solderparty/rp2040_stamp_carrier_hw/schematics.pdf

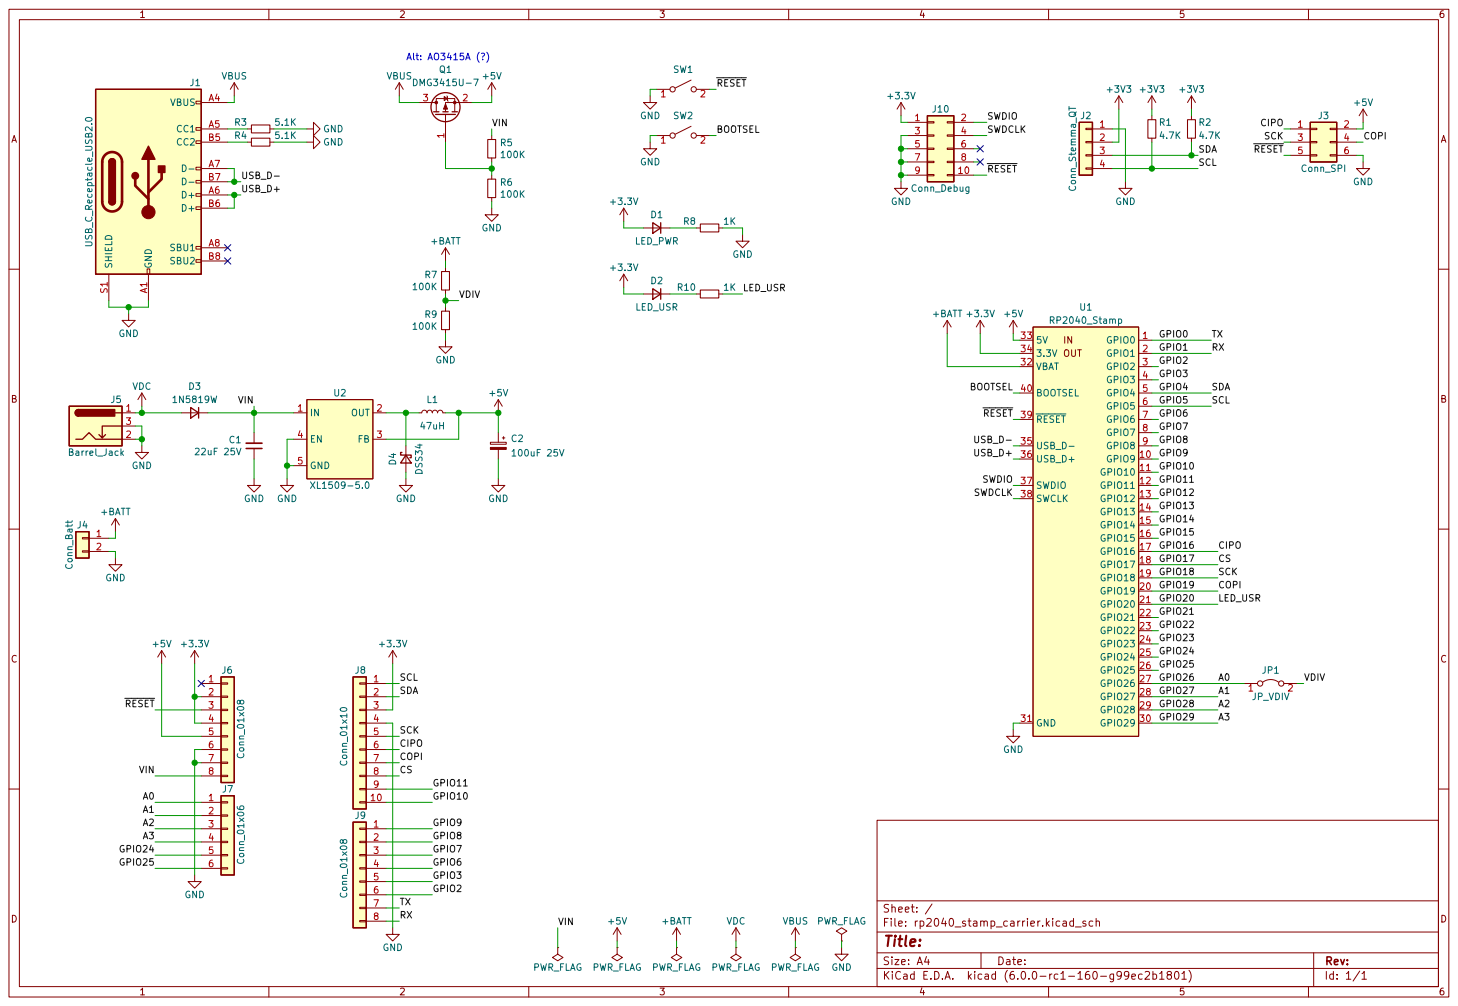
[picture p2: page 1]
