solderparty/rp2040_stamp_carrier_hw/rp2040_stamp_carrier.kicad_sch

## KiCad design rp2040_stamp_carrier.kicad_sch (2021-10-28)

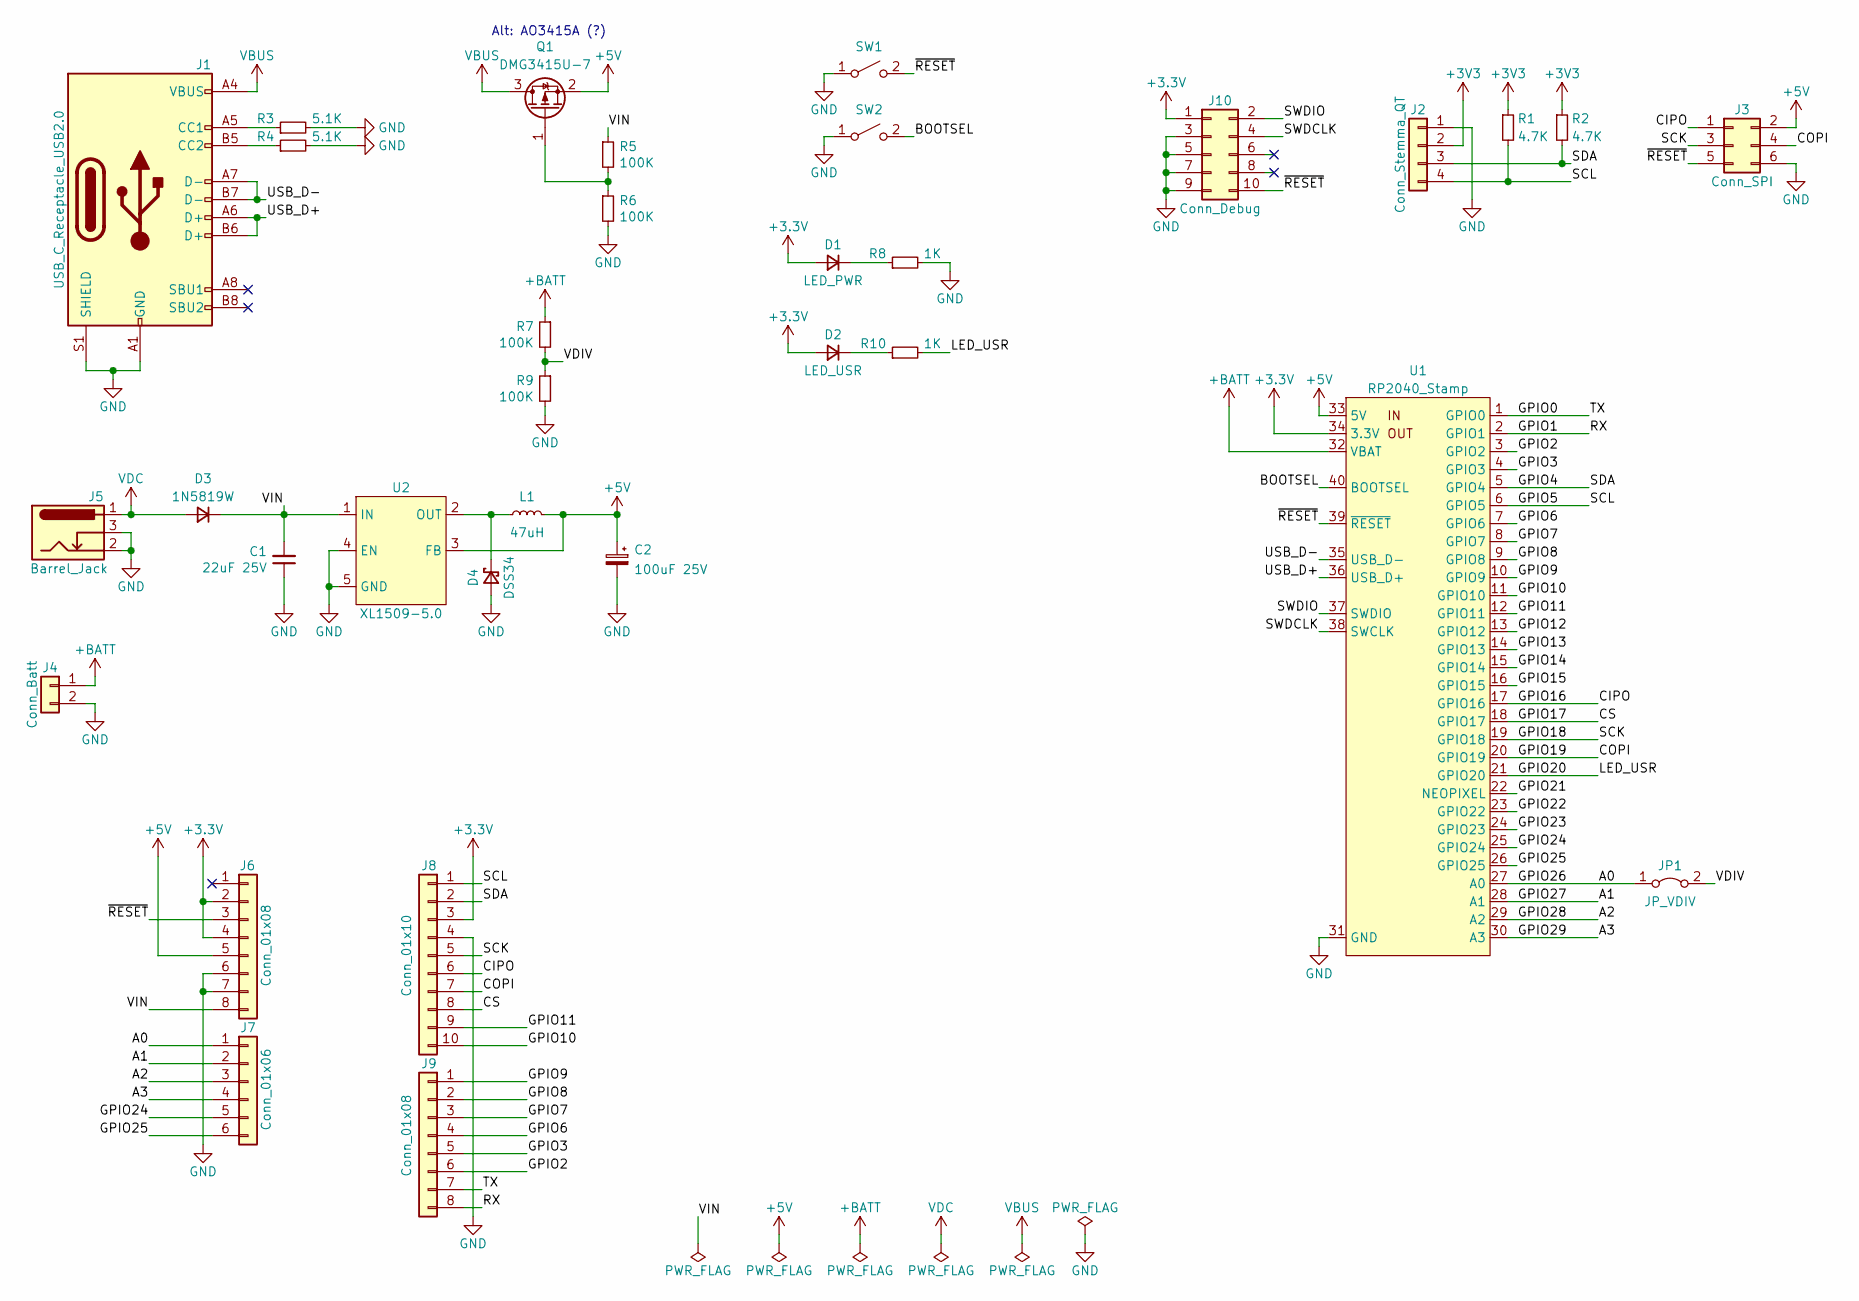
[picture p3: schematic rp2040_stamp_carrier.kicad_sch]

Parts:
C1: 22uF 25V; C_0805_2012Metric; LCSC C45783
C2: 100uF 25V; CP_Elec_6.3x4.9; LCSC C72477
D1: LED_PWR; LED_0603_1608Metric
D2: LED_USR; LED_0603_1608Metric
D3: 1N5819W; D_SOD-123; LCSC C369930
D4: DSS34; D_SOD-123F; LCSC C84632
J1: USB_C_Receptacle_USB2.0; USB_C_Receptacle_XKB_U262-16XN-4BVC11; LCSC C319148
J2: Conn_Stemma_QT; JST_SH_SM04B-SRSS-TB_1x04-1MP_P1.00mm_Horizontal; LCSC C160404
J3: Conn_SPI; PinHeader_2x03_P2.54mm_Vertical
J4: Conn_Batt; JST_PH_S2B-PH-SM4-TB_1x02-1MP_P2.00mm_Horizontal; LCSC C47647
J5: Barrel_Jack; BarrelJack_Horizontal; LCSC C16214
J6, J9: Conn_01x08; PinSocket_1x08_P2.54mm_Vertical
J7: Conn_01x06; PinSocket_1x06_P2.54mm_Vertical
J8: Conn_01x10; PinSocket_1x10_P2.54mm_Vertical
J10: Conn_Debug; PinHeader_2x05_P1.27mm_Vertical_SMD_IDC
JP1: JP_VDIV; SolderJumper-2_P1.3mm_Bridged_RoundedPad1.0x1.5mm
L1: 47uH; L_Bourns_SRP7028A_7.3x6.6mm; LCSC C149588
Q1: DMG3415U-7; SOT-23; LCSC C96616
R1, R2: 4.7K; R_0603_1608Metric
R3, R4: 5.1K; R_0603_1608Metric
R5, R6, R7, R9: 100K; R_0603_1608Metric
R8, R10: 1K; R_0603_1608Metric
SW1, SW2: BTN_UP; TL3330; LCSC C318936
U1: RP2040_Stamp; RP2040_Stamp_THT
U2: XL1509-5.0; SOP-8_3.9x4.9mm_P1.27mm; LCSC C2681225

Connections:
+3.3V: D1.2 (A), D2.2 (A), J6.2, J6.4, J8.3, J10.1, U1.34 (3.3V)
+3V3: J2.2, R1.1, R2.1
+5V: C2.1, J3.2, J6.5, L1.2, Q1.2 (S), U1.33 (5V), U2.3 (FB)
+BATT: J4.1, R7.1, U1.32 (VBAT)
A0: J7.1, JP1.1 (A), U1.27 (GPIO26)
A1: J7.2, U1.28 (GPIO27)
A2: J7.3, U1.29 (GPIO28)
A3: J7.4, U1.30 (GPIO29)
BOOTSEL: SW2.2 (B), U1.40 (BOOTSEL)
CIPO: J3.1, J8.6, U1.17 (GPIO16)
COPI: J3.4, J8.7, U1.20 (GPIO19)
CS: J8.8, U1.18 (GPIO17)
GND: C1.1, C2.2, D4.2 (A), J1.A1 (GND), J1.A12 (GND), J1.B1 (GND), J1.B12 (GND), J1.S1 (SHIELD), J2.1, J3.6, J4.2, J5.2, J5.3, J6.6, J6.7, J8.4, J10.3, J10.5, J10.7, J10.9, R3.2, R4.2, R6.2, R8.2, R9.2, SW1.1 (A), SW2.1 (A), U1.31 (GND), U2.4 (EN), U2.5 (GND), U2.6 (GND), U2.7 (GND), U2.8 (GND)
GPIO0: J9.7, U1.1 (GPIO0)
GPIO1: J9.8, U1.2 (GPIO1)
GPIO2: J9.6, U1.3 (GPIO2)
GPIO3: J9.5, U1.4 (GPIO3)
GPIO4: J2.3, J8.2, R2.2, U1.5 (GPIO4)
GPIO5: J2.4, J8.1, R1.2, U1.6 (GPIO5)
GPIO6: J9.4, U1.7 (GPIO6)
GPIO7: J9.3, U1.8 (GPIO7)
GPIO8: J9.2, U1.9 (GPIO8)
GPIO9: J9.1, U1.10 (GPIO9)
GPIO10: J8.10, U1.11 (GPIO10)
GPIO11: J8.9, U1.12 (GPIO11)
GPIO12: U1.13 (GPIO12)
GPIO13: U1.14 (GPIO13)
GPIO14: U1.15 (GPIO14)
GPIO15: U1.16 (GPIO15)
GPIO18: J3.3, J8.5, U1.19 (GPIO18)
GPIO20: R10.2, U1.21 (GPIO20)
GPIO21: U1.22 (GPIO21)
GPIO22: U1.23 (GPIO22)
GPIO23: U1.24 (GPIO23)
GPIO24: J7.5, U1.25 (GPIO24)
GPIO25: J7.6, U1.26 (GPIO25)
unnamed: D1.1 (K), R8.1
unnamed: D2.1 (K), R10.1
unnamed: D4.1 (K), L1.1, U2.2 (OUT)
unnamed: J1.A5 (CC1), R3.1
unnamed: J1.B5 (CC2), R4.1
unnamed: Q1.1 (G), R5.2, R6.1
SWDCLK: J10.4, U1.38 (SWCLK)
SWDIO: J10.2, U1.37 (SWDIO)
USB_D+: J1.A6 (D+), J1.B6 (D+), U1.36 (USB_D+)
USB_D-: J1.A7 (D-), J1.B7 (D-), U1.35 (USB_D-)
VBUS: J1.A4 (VBUS), J1.A9 (VBUS), J1.B4 (VBUS), J1.B9 (VBUS), Q1.3 (D)
VDC: D3.2 (A), J5.1
VDIV: JP1.2 (B), R7.2, R9.1
VIN: C1.2, D3.1 (K), J6.8, R5.1, U2.1 (IN)
~RESET: J3.5, J6.3, J10.10, SW1.2 (B), U1.39 (~RESET)

Notes on the sheet:
Alt: AO3415A (?)
