solderparty/rp2040_stamp_carrier_hw/(threads)

Thread 1 (2024-08-09):

How can I get the Bill of Materials(BOM) to make this carrier?

certram, 2024-08-09:
I only find the ibom.html in the project,but when I use an online html tool to open it.It's empty. So how can I get the concrete BOM file?

arturo182, 2024-08-09:
If you download the ibom html file, it should open properly:
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

You can also download the KiCad project and open it to see the BOM.

certram, 2024-08-12:
OK,it's useful.

certram, 2024-08-12:
Here is an another problem when I run the DRC rule in the rp2040_stamp_carrier.kicad_pcb file,the result is as shown below:
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

certram, 2024-08-12:
How can I fix it? My KiCad version is latest:8.04.

arturo182, 2024-08-12:
This board was designed 3 years ago when KiCad was at version ~6, some of these DRC checks didn't exist back then and the other ones are safe to ignore. The files in this repo are what was used for mass production and there have been no problems reported with them so please just ignore the DRC and produce the boards as-is.

certram, 2024-08-15:
Thanks very much! Now I am going to take a SMT order(I send the position file and bom file),but the factory  customer support send the result back to me. He tell me I should ensure some components type. I don't know how to fix it. Can you tell me the solution?[
[G3344799_5套_报价单.xls](https://github.com/user-attachments/files/16622578/G3344799_5._.xls)
](url)

certram, 2024-08-15:
Sorry! The above problem is not about carrier board! It's about rp2040 stamp.

arturo182, 2024-08-15:
For J1, J2, J3, J4, JP1, JP2, they are just pads on the board, so there's no component or assembly. For D2 just use any orange 0603 LED, for D1 use https://www.lcsc.com/product-detail/Schottky-Diodes_MDD-Microdiode-Semiconductor-B5817WS-SJ_C114023.html or similar.

certram, 2024-10-12:
Hello,about the rp2040 carrier board, in bom file, I see the footprint is CP_Elec_6.3x4.9, but I can't find this size, can you give the specific manufacturer or production number?

arturo182, 2024-10-12:
This is the part used in production, but most 100uF 25V electrolytic capacitors should be oke:
https://www.lcsc.com/product-detail/Aluminum-Electrolytic-Capacitors-SMD_ROQANG-RVT1E101M0607_C72477.html

certram, 2024-11-19:
Hello,I have already had the rp2040 stamp and the rp2040 carrier board, how can I solder the stamp to carrier board? Do you use the pin headers or combine them only with tin(Sn) ?

arturo182, 2024-11-19:
The Carrier supports both options, you can solder the Stamp directly to the Carrier with tin, or you can use a 2mm-pitch header.

certram, 2024-11-20:
OK! Thanks

Closed 2024-11-20.
