solderparty/rp2040_stamp_carrier_hw/(commit log)

2021-10-28 Initial import
    [rp2040_stamp_carrier.kicad_pcb, rp2040_stamp_carrier.kicad_sch]
2021-12-02 README, license, schematics
